titaofdata/CaRE-publication/README.md

# CaRE-publication

Included here are the papers and source code for CaRE: Cardiac Rehabilitation Equipment.

Here's the [link](https://drive.google.com/file/d/17aydVSoKhNK8wmkvWnyo0R7zJxaTYyjX/view?usp=sharing) to the paper from the field test release.
