titaofdata/CaRE-publication/User Interface/care_dialog_FINAL.py

# -*- coding: utf-8 -*-

# Form implementation generated from reading ui file 'care_dialog.ui'
#
# Created by: PyQt4 UI code generator 4.11.4
#
# WARNING! All changes made in this file will be lost!

from PyQt4 import QtCore, QtGui

try:
    _fromUtf8 = QtCore.QString.fromUtf8
except AttributeError:
    def _fromUtf8(s):
        return s

try:
    _encoding = QtGui.QApplication.UnicodeUTF8
    def _translate(context, text, disambig):
        return QtGui.QApplication.translate(context, text, disambig, _encoding)
except AttributeError:
    def _translate(context, text, disambig):
        return QtGui.QApplication.translate(context, text, disambig)

class Ui_Dialog(object):
    def setupUi(self, Dialog):
        Dialog.setObjectName(_fromUtf8("Dialog"))
        Dialog.resize(250, 171)
        Dialog.setAutoFillBackground(True)
        self.verticalLayout_4 = QtGui.QVBoxLayout(Dialog)
        self.verticalLayout_4.setObjectName(_fromUtf8("verticalLayout_4"))
        self.horizontalLayout_2 = QtGui.QHBoxLayout()
        self.horizontalLayout_2.setObjectName(_fromUtf8("horizontalLayout_2"))
        self.verticalLayout = QtGui.QVBoxLayout()
        self.verticalLayout.setObjectName(_fromUtf8("verticalLayout"))
        self.label = QtGui.QLabel(Dialog)
        font = QtGui.QFont()
        font.setPointSize(14)
        self.label.setFont(font)
        self.label.setAlignment(QtCore.Qt.AlignRight|QtCore.Qt.AlignTrailing|QtCore.Qt.AlignVCenter)
        self.label.setObjectName(_fromUtf8("label"))
        self.verticalLayout.addWidget(self.label)
        self.label_5 = QtGui.QLabel(Dialog)
        font = QtGui.QFont()
        font.setPointSize(14)
        self.label_5.setFont(font)
        self.label_5.setAlignment(QtCore.Qt.AlignRight|QtCore.Qt.AlignTrailing|QtCore.Qt.AlignVCenter)
        self.label_5.setObjectName(_fromUtf8("label_5"))
        self.verticalLayout.addWidget(self.label_5)
        self.label_4 = QtGui.QLabel(Dialog)
        font = QtGui.QFont()
        font.setPointSize(14)
        self.label_4.setFont(font)
        self.label_4.setAlignment(QtCore.Qt.AlignRight|QtCore.Qt.AlignTrailing|QtCore.Qt.AlignVCenter)
        self.label_4.setObjectName(_fromUtf8("label_4"))
        self.verticalLayout.addWidget(self.label_4)
        self.horizontalLayout_2.addLayout(self.verticalLayout)
        self.verticalLayout_2 = QtGui.QVBoxLayout()
        self.verticalLayout_2.setObjectName(_fromUtf8("verticalLayout_2"))
        self.duration_lineEdit = QtGui.QLineEdit(Dialog)
        sizePolicy = QtGui.QSizePolicy(QtGui.QSizePolicy.Expanding, QtGui.QSizePolicy.Minimum)
        sizePolicy.setHorizontalStretch(0)
        sizePolicy.setVerticalStretch(0)
        sizePolicy.setHeightForWidth(self.duration_lineEdit.sizePolicy().hasHeightForWidth())
        self.duration_lineEdit.setSizePolicy(sizePolicy)
        font = QtGui.QFont()
        font.setPointSize(14)
        self.duration_lineEdit.setFont(font)
        self.duration_lineEdit.setAlignment(QtCore.Qt.AlignRight|QtCore.Qt.AlignTrailing|QtCore.Qt.AlignVCenter)
        self.duration_lineEdit.setObjectName(_fromUtf8("duration_lineEdit"))
        self.verticalLayout_2.addWidget(self.duration_lineEdit)
        self.restinghr_lineEdit_2 = QtGui.QLineEdit(Dialog)
        sizePolicy = QtGui.QSizePolicy(QtGui.QSizePolicy.Expanding, QtGui.QSizePolicy.Minimum)
        sizePolicy.setHorizontalStretch(0)
        sizePolicy.setVerticalStretch(0)
        sizePolicy.setHeightForWidth(self.restinghr_lineEdit_2.sizePolicy().hasHeightForWidth())
        self.restinghr_lineEdit_2.setSizePolicy(sizePolicy)
        font = QtGui.QFont()
        font.setPointSize(14)
        self.restinghr_lineEdit_2.setFont(font)
        self.restinghr_lineEdit_2.setAlignment(QtCore.Qt.AlignRight|QtCore.Qt.AlignTrailing|QtCore.Qt.AlignVCenter)
        self.restinghr_lineEdit_2.setObjectName(_fromUtf8("restinghr_lineEdit_2"))
        self.verticalLayout_2.addWidget(self.restinghr_lineEdit_2)
        self.maxtargethr_lineEdit_4 = QtGui.QLineEdit(Dialog)
        sizePolicy = QtGui.QSizePolicy(QtGui.QSizePolicy.Expanding, QtGui.QSizePolicy.Minimum)
        sizePolicy.setHorizontalStretch(0)
        sizePolicy.setVerticalStretch(0)
        sizePolicy.setHeightForWidth(self.maxtargethr_lineEdit_4.sizePolicy().hasHeightForWidth())
        self.maxtargethr_lineEdit_4.setSizePolicy(sizePolicy)
        font = QtGui.QFont()
        font.setPointSize(14)
        self.maxtargethr_lineEdit_4.setFont(font)
        self.maxtargethr_lineEdit_4.setAlignment(QtCore.Qt.AlignRight|QtCore.Qt.AlignTrailing|QtCore.Qt.AlignVCenter)
        self.maxtargethr_lineEdit_4.setObjectName(_fromUtf8("maxtargethr_lineEdit_4"))
        self.verticalLayout_2.addWidget(self.maxtargethr_lineEdit_4)
        self.horizontalLayout_2.addLayout(self.verticalLayout_2)
        self.verticalLayout_3 = QtGui.QVBoxLayout()
        self.verticalLayout_3.setObjectName(_fromUtf8("verticalLayout_3"))
        self.label_2 = QtGui.QLabel(Dialog)
        font = QtGui.QFont()
        font.setPointSize(14)
        self.label_2.setFont(font)
        self.label_2.setAlignment(QtCore.Qt.AlignRight|QtCore.Qt.AlignTrailing|QtCore.Qt.AlignVCenter)
        self.label_2.setObjectName(_fromUtf8("label_2"))
        self.verticalLayout_3.addWidget(self.label_2)
        self.label_6 = QtGui.QLabel(Dialog)
        font = QtGui.QFont()
        font.setPointSize(14)
        self.label_6.setFont(font)
        self.label_6.setAlignment(QtCore.Qt.AlignRight|QtCore.Qt.AlignTrailing|QtCore.Qt.AlignVCenter)
        self.label_6.setObjectName(_fromUtf8("label_6"))
        self.verticalLayout_3.addWidget(self.label_6)
        self.label_3 = QtGui.QLabel(Dialog)
        font = QtGui.QFont()
        font.setPointSize(14)
        self.label_3.setFont(font)
        self.label_3.setAlignment(QtCore.Qt.AlignRight|QtCore.Qt.AlignTrailing|QtCore.Qt.AlignVCenter)
        self.label_3.setObjectName(_fromUtf8("label_3"))
        self.verticalLayout_3.addWidget(self.label_3)
        self.horizontalLayout_2.addLayout(self.verticalLayout_3)
        self.verticalLayout_4.addLayout(self.horizontalLayout_2)
        self.errorhandle_label_5 = QtGui.QLabel(Dialog)
        sizePolicy = QtGui.QSizePolicy(QtGui.QSizePolicy.Preferred, QtGui.QSizePolicy.Maximum)
        sizePolicy.setHorizontalStretch(0)
        sizePolicy.setVerticalStretch(0)
        sizePolicy.setHeightForWidth(self.errorhandle_label_5.sizePolicy().hasHeightForWidth())
        self.errorhandle_label_5.setSizePolicy(sizePolicy)
        self.errorhandle_label_5.setText(_fromUtf8(""))
        self.errorhandle_label_5.setAlignment(QtCore.Qt.AlignCenter)
        self.errorhandle_label_5.setObjectName(_fromUtf8("errorhandle_label_5"))
        self.verticalLayout_4.addWidget(self.errorhandle_label_5)
        self.horizontalLayout = QtGui.QHBoxLayout()
        self.horizontalLayout.setObjectName(_fromUtf8("horizontalLayout"))
        spacerItem = QtGui.QSpacerItem(40, 20, QtGui.QSizePolicy.Expanding, QtGui.QSizePolicy.Minimum)
        self.horizontalLayout.addItem(spacerItem)
        self.confirm_pushButton = QtGui.QPushButton(Dialog)
        sizePolicy = QtGui.QSizePolicy(QtGui.QSizePolicy.Fixed, QtGui.QSizePolicy.Fixed)
        sizePolicy.setHorizontalStretch(0)
        sizePolicy.setVerticalStretch(0)
        sizePolicy.setHeightForWidth(self.confirm_pushButton.sizePolicy().hasHeightForWidth())
        self.confirm_pushButton.setSizePolicy(sizePolicy)
        self.confirm_pushButton.setObjectName(_fromUtf8("confirm_pushButton"))
        self.horizontalLayout.addWidget(self.confirm_pushButton)
        spacerItem1 = QtGui.QSpacerItem(40, 20, QtGui.QSizePolicy.Expanding, QtGui.QSizePolicy.Minimum)
        self.horizontalLayout.addItem(spacerItem1)
        self.verticalLayout_4.addLayout(self.horizontalLayout)

        self.retranslateUi(Dialog)
        QtCore.QMetaObject.connectSlotsByName(Dialog)

    def retranslateUi(self, Dialog):
        Dialog.setWindowTitle(_translate("Dialog", "Dialog", None))
        self.label.setText(_translate("Dialog", "Duration:", None))
        self.label_5.setText(_translate("Dialog", "Resting HR:", None))
        self.label_4.setText(_translate("Dialog", "Target HR:", None))
        self.duration_lineEdit.setText(_translate("Dialog", "0", None))
        self.restinghr_lineEdit_2.setText(_translate("Dialog", "0", None))
        self.maxtargethr_lineEdit_4.setText(_translate("Dialog", "0", None))
        self.label_2.setText(_translate("Dialog", "min", None))
        self.label_6.setText(_translate("Dialog", "bpm", None))
        self.label_3.setText(_translate("Dialog", "bpm", None))
        self.confirm_pushButton.setText(_translate("Dialog", "START", None))


if __name__ == "__main__":
    import sys
    app = QtGui.QApplication(sys.argv)
    Dialog = QtGui.QDialog()
    ui = Ui_Dialog()
    ui.setupUi(Dialog)
    Dialog.show()
    sys.exit(app.exec_())
