titaofdata/CaRE-publication/(commit log)

2021-03-18 added arduino and ML algo files
2021-04-19 added heartsmart pitch
